ssivtoo/Tennis-for-Two-by-Arduino-with-OLED/parabola/parabola.ino

#define SCREEN_WIDTH 256
#define SCREEN_HEIGHT 256

void setup()
{
  DDRB = 255; // Set all pins on PORTB to output
  DDRD = 255; // Set all pins on PORTD to output
  pinMode(A0, OUTPUT);
  pinMode(A1, OUTPUT);
  // Serial.begin(115200);
}

void writey(uint8_t coord)
{
  PORTD = coord;
}

void writex(uint8_t coord)
{
  // Step 1: Convert to binary
  String binary = String(coord, BIN);

  // Step 2: Pad with zeros if necessary
  int bitAsInt[8]; // Declare the variable bitAsInt

  while (binary.length() < 8)
  {
    binary = "0" + binary;
  }

  // Step 3: Split into 8 numbers
  for (int i = 0; i < 8; ++i)
  {
    char bit = binary.charAt(i);
    // Convert char to int and do something with it
    bitAsInt[i] = bit - '0';                     // Assign the value to bitAsInt array
    bitAsInt[i] = bitAsInt[i] == 1 ? HIGH : LOW; // Convert 1 to HIGH and 0 to LOW
  }
  Serial.println();
  digitalWrite(8, bitAsInt[0]);
  digitalWrite(9, bitAsInt[1]);
  digitalWrite(10, bitAsInt[2]);
  digitalWrite(11, bitAsInt[3]);
  digitalWrite(12, bitAsInt[4]);
  digitalWrite(13, bitAsInt[5]);
  digitalWrite(A2, bitAsInt[6]);
  digitalWrite(A3, bitAsInt[7]);
}

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
  // writey(0);
  // writex(127);
  // writey(0);
  // writex(255);
  // writey(0);
  // writex(0);
  // writey(127);
  // writex(127);
  // writey(127);
  // writex(255);
  // writey(127);
  // writex(0);
  // writey(255);
  // writex(127);
  // writey(255);
  // writex(255);
  // writey(255);
}
