ssivtoo/Tennis-for-Two-by-Arduino-with-OLED/(commit log)

2024-01-18 Add circuit diagrams
2024-01-21 update circuit diagram and code comments
2024-01-21 Update circuit diagram
2024-01-26 Edit README and attached bibliography
